Outsmarting-Disaster/OD-buoy/README.md

# outsmarting disaster buoy
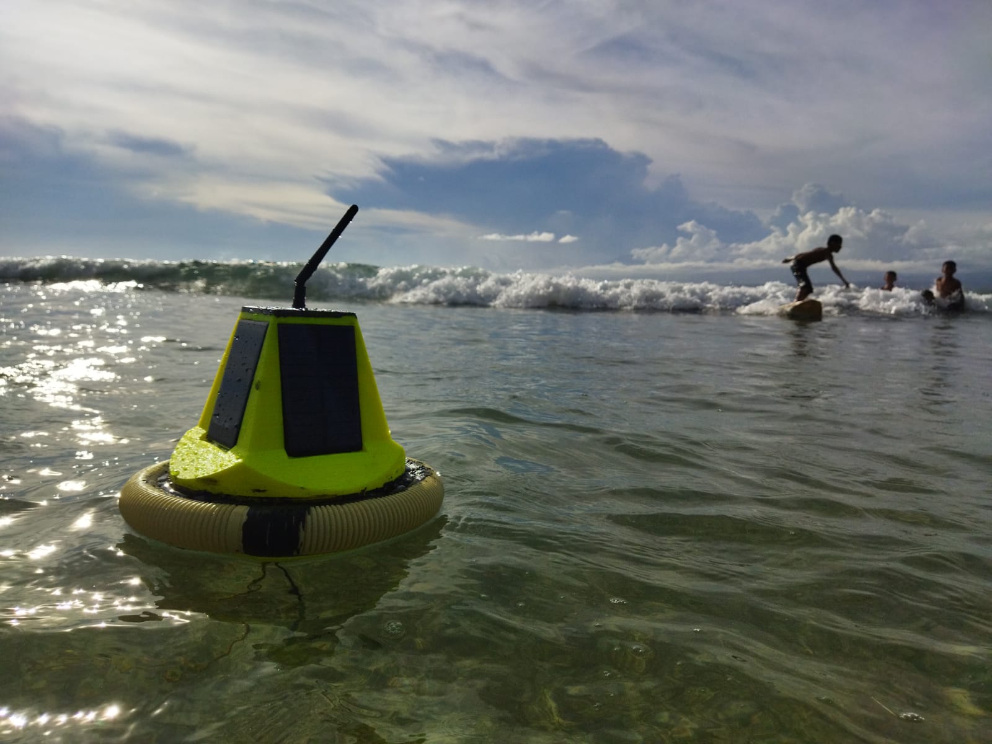
[picture p1: assets/OD-buoyTesting.jpeg]
My image
   

output data

- wave height
- wave periodic 
- wave power
- water temprature
- air terprature
