Outsmarting-Disaster/OD-buoy/assets/teamwork.jpeg

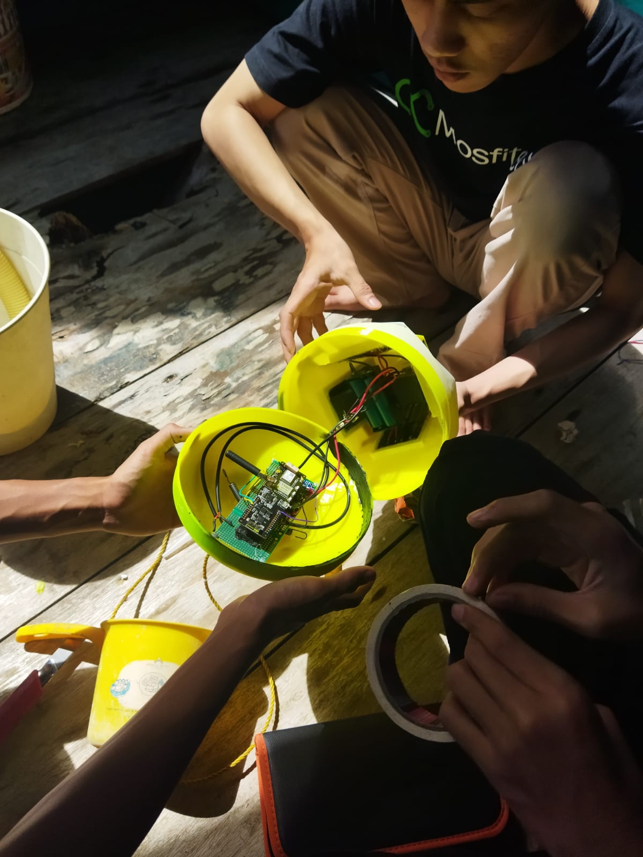
assets/teamwork.jpeg
